Cinnnnnnndy/Huawei-Pura-X-Max-stand/preview/5_back_camera.png

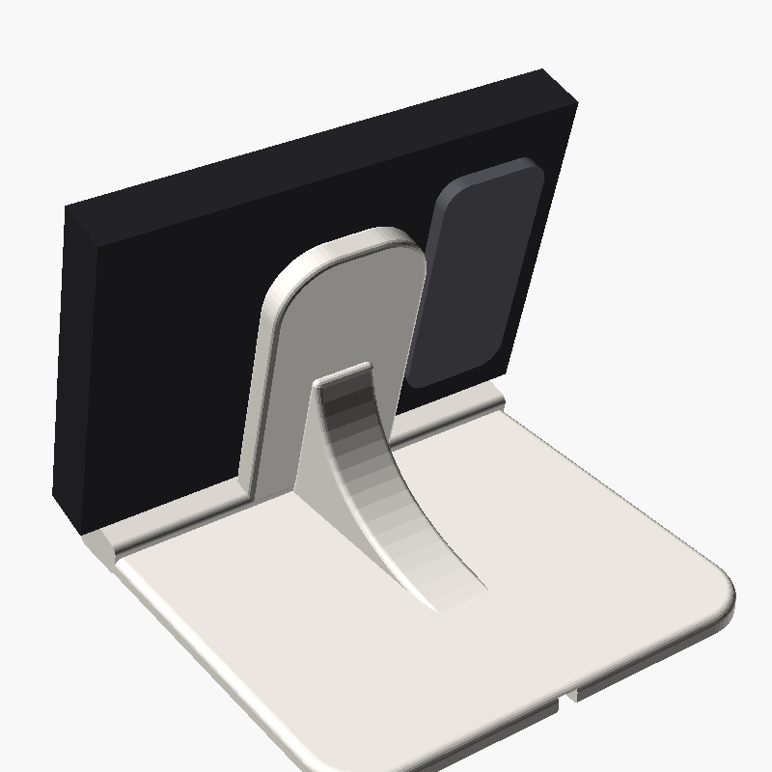
preview/5_back_camera.png
