Cinnnnnnndy/Huawei-Pura-X-Max-stand/preview/6_stand.png

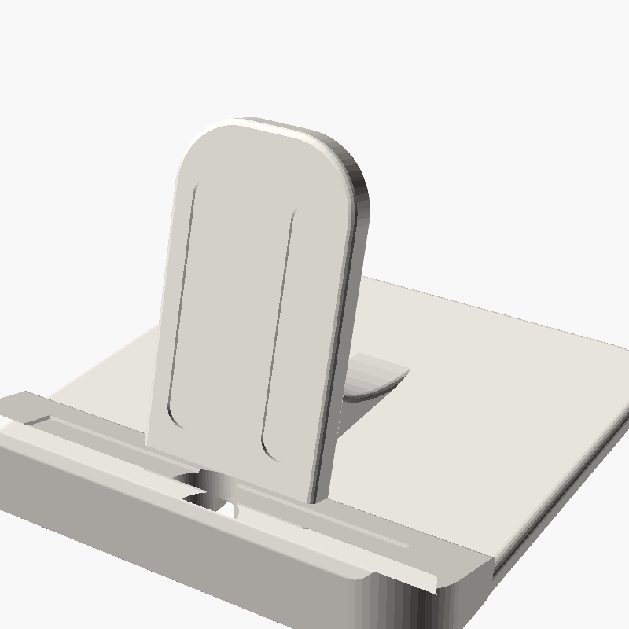
preview/6_stand.png
