Cinnnnnnndy/Huawei-Pura-X-Max-stand/preview/7_side.png

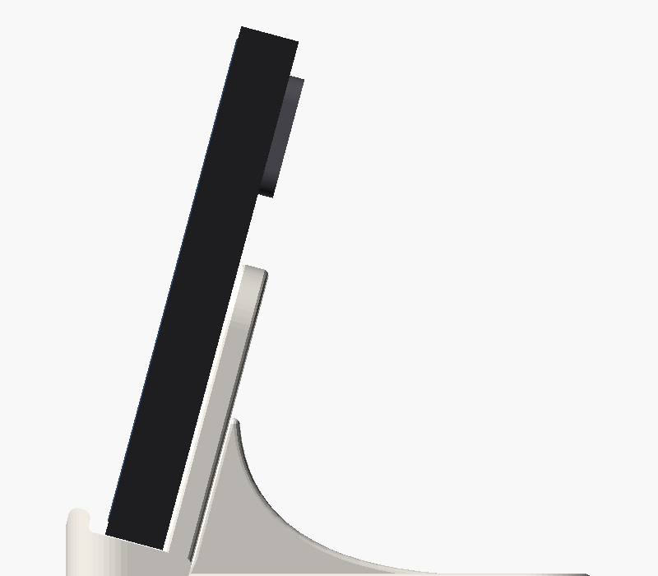
preview/7_side.png
