Cinnnnnnndy/Huawei-Pura-X-Max-stand/preview/8_slot_open_landscape.png

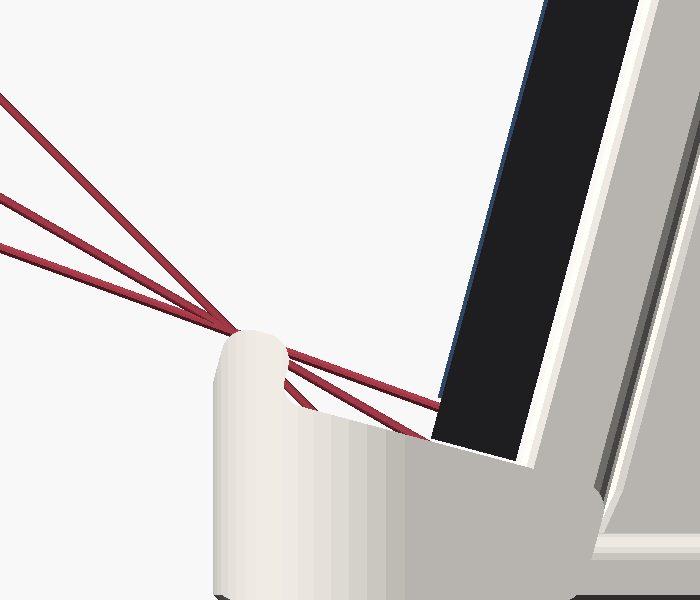
preview/8_slot_open_landscape.png
