Cinnnnnnndy/Huawei-Pura-X-Max-stand/stl/pads_tpu.stl

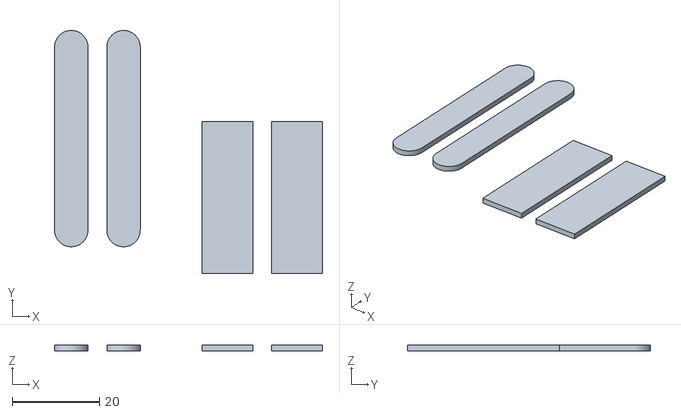
[picture p10: CAD file, 2026-10-29]
stl/pads_tpu.stl
61.5 x 55.9 x 1.30
