Cinnnnnnndy/Huawei-Pura-X-Max-stand/stl/stand.stl

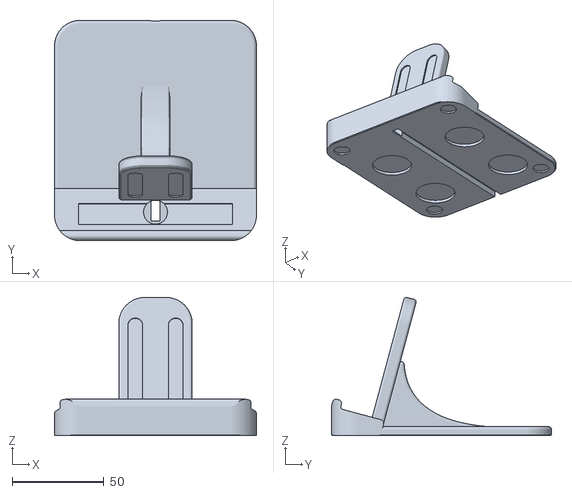
[picture p11: CAD file, 2026-10-29]
stl/stand.stl
110.0 x 120.0 x 75.3
